gyuha/macbook-dust-cover/.forge/STATUS.md

# STATUS — 가운데 이음의 M3 나사를 스냅 후크로 교체
slug: seam-snap-hook
status: executed
executed: 2026-10-28
verified: skipped (실물 출력 전 — 자동 검사 check_cover.py PASS 5 / FAIL 0, 턱 0.01 시험에서 (e) FAIL 확인)
retro: pending
