gyuha/macbook-dust-cover/.forge/followups.md

# Follow-ups

<!-- followup: fu-b77e70e10287 | source: macbook-m5-vent-dust-cover | task: 1 | date: 2026-10-27 | status: open | taken: - -->
- 아치 지붕을 처마형(위 지붕을 띄우고 양옆에 낮은 처마 조각을 두어 사이 틈으로 좌우 배기)으로 바꾼다. 먼지는 막고 공기는 원활히 빠지게 한다.
  Evidence: 사용자가 아치 지붕 아래에 바람이 머물러 배기에 불리하다고 지적하고 참고 이미지를 제시했다.
