gyuha/macbook-dust-cover/.forge/retro/261027-151405-macbook-m5-vent-dust-cover.md

# 2026-10-27 — MacBook Pro 14" M5 환기구 먼지 덮개 (FreeCAD 파라메트릭, 2조각 출력)

## Plan vs actual
- 계획대로 된 것: `dust_cover.py`/`check_cover.py`/`README.md` 3개 산출물, DoD 1·2 통과(재실행 PASS 5줄, FAIL 0줄). 지붕 안쪽 간격 12mm, 슬릿 구간 아래 다리 없음.
- 어긋난 것: 사용자 피드백으로 5회 재설계. 아치 지붕·둥근 끝 → 핀 대신 평면 도브테일 → 세워서 적층하는 H자 탭·원형 홀 → 안쪽 탭 홀 제거·이음선 맞닿음 → 모서리 라운드와 U자 바닥. 이후 M3 나사 결합으로 이음을 교체(커밋 423f12e). 계획의 "겹침 이음"이 도브테일을 거쳐 나사 결합으로 바뀌었다.
- 원인: 계획에 FDM 출력 방향·서포트 제약이 없었다. 지붕 형상(아치)이 배기 흐름에 미치는 영향도 계획 단계에서 검토하지 않았다.
- UAT는 실물 출력 전이라 `skipped`로 봉인. 아치 지붕은 바람이 지붕 아래에 머물 수 있어 처마형으로 대체하기로 했다.

## Learnings
- 다음에는 계획 단계에서 출력 방향(어느 면을 베드에 댈지)과 서포트 허용 여부를 먼저 정한다. `check_cover.py`에 오버행 45° 덩어리 면적 검사를 넣은 방식은 재사용할 만하다.
- 공기 흐름이 목적인 형상은 아치/평면 같은 모양을 정하기 전에 공기가 어느 경로로 빠지는지를 먼저 그림으로 합의한다. 이번에는 사용자가 이후 이미지(처마 구조)로 의도를 보여 줘서야 드러났다.
- 이음 결합(핀 → 도브테일 → 나사)이 세 번 바뀌었다. 조립 강도 요구는 계획에 적고 시작한다.
- 검증 스크립트는 일부러 틀린 파라미터(GAP=20, OVERLAP=30)로 FAIL이 나는지 확인해야 신뢰할 수 있다. 이번에 그렇게 확인했다. `SystemExit` 직전에는 stdout flush가 필요하다.

## Doc updates
- CONTEXT.md promotion: none
- ADR added: none

## Follow-up candidates
<!-- followup: fu-b77e70e10287 | source: macbook-m5-vent-dust-cover | task: 1 | date: 2026-10-27 | status: open | taken: - -->
- 아치 지붕을 처마형(위 지붕을 띄우고 양옆에 낮은 처마 조각을 두어 사이 틈으로 좌우 배기)으로 바꾼다. 먼지는 막고 공기는 원활히 빠지게 한다.
  Evidence: 사용자가 아치 지붕 아래에 바람이 머물러 배기에 불리하다고 지적하고 참고 이미지를 제시했다.
