gyuha/macbook-dust-cover/.forge/done/261027-151409-macbook-m5-vent-dust-cover/STATUS.md

# STATUS — MacBook Pro 14" M5 환기구 먼지 덮개
slug: macbook-m5-vent-dust-cover
status: done
executed: 2026-10-24
completed: 2026-10-27
verified: skipped (실물 출력 전; 아치 지붕을 처마형으로 바꾸는 새 작업으로 대체. 자동 검증 DoD 1·2 재실행 통과)
retro: .forge/retro/261027-151405-macbook-m5-vent-dust-cover.md
docs updated: none
