gyuha/macbook-dust-cover/cover-left.stl

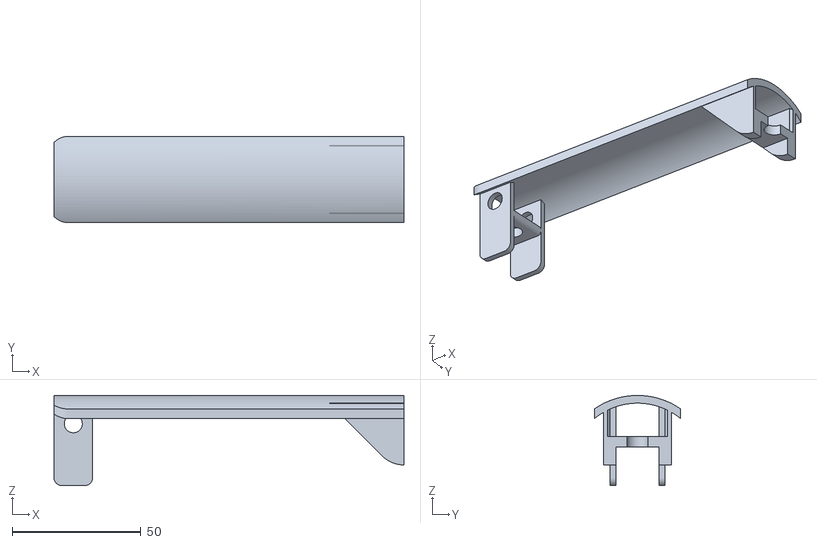
[picture p8: CAD file, 2026-10-28]
cover-left.stl
136.0 x 33.5 x 35.0
