gyuha/macbook-dust-cover/cover-right.stl

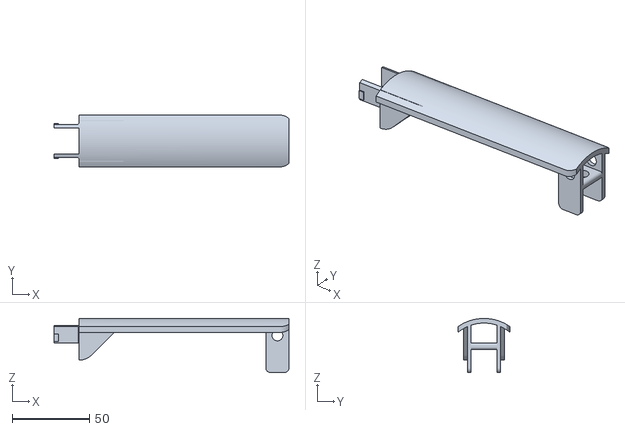
[picture p9: CAD file, 2026-10-28]
cover-right.stl
152.0 x 33.5 x 35.0
