gyuha/macbook-dust-cover/(commit log)

2026-10-24 Add FreeCAD dust cover model, geometry checks, and print guide
    [cover-left.stl, cover-right.stl]
2026-10-24 Round cover corners and join center legs into a U-bottom
    [cover-left.stl, cover-right.stl]
2026-10-24 Add seam bar hole and tighten dovetail clearance to 0.05mm
    [cover-left.stl, cover-right.stl]
2026-10-25 Replace dovetail seam with overlapping legs and M3 screws
    [cover-left.stl, cover-right.stl]
2026-10-28 Replace seam screws with snap hook and thin roof to 3mm
    [cover-left.stl, cover-right.stl]
